MohdAltaaf/Keychains/BOM.csv

Part Name | Quantity | Unit Price | Total Price | Purchase Link
Seeed Studio XIAO ESP32C3 | 2 | 8.89$ | 17.78$ | https://techiesms.com/product/seeed-studio-xiao-esp32c3-the-smallest-esp32c3-development-board/
1.3 Inch I2C OLED 4-pin SH1106 | 2 | 3.89$ | 7.78$ | https://shop.controllerstech.com/products/1-3-inch-i2c-oled-display-module-4pin-white-sh1106
KP 481035 150mAh 3.7V LiPo Battery | 2 | 3.33$ | 6.66$ | https://zbotic.in/product/kp-original-481035-150mah-3-7vsingle-cell-rechargeable-lipo-battery/
Mini SPDT Slide Switch 3-pin | 2 | 0.22$ | 0.44$ | https://probots.co.in/mini-spdt-slide-switch-3-pin-pcb-mount.html
3D-printed enclosure (own STL) | 2 | 1.67$ | 3.34$
Delivery Charges and shipping (if applicable) |  |  | 10$
Grand Total |  |  | 46.00$
