MohdAltaaf/Keychains/3D Model/Full body.step

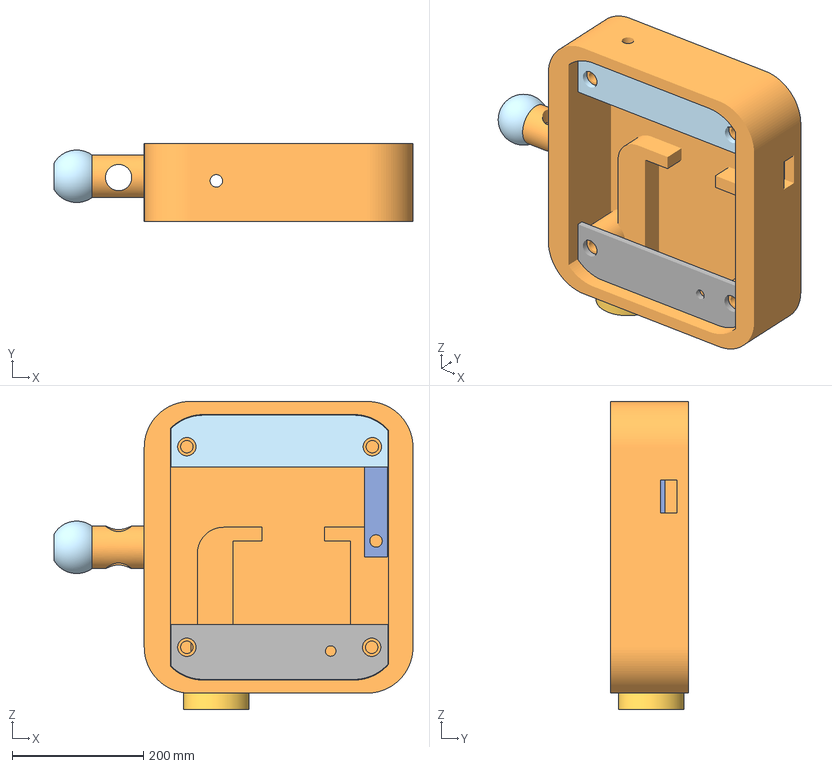
[picture p1: CAD file, 2026-10-27]
3D Model/Full body.step
547.7 x 119.0 x 470.0 mm
