MohdAltaaf/Keychains/3D Model/Switch_cover.stl

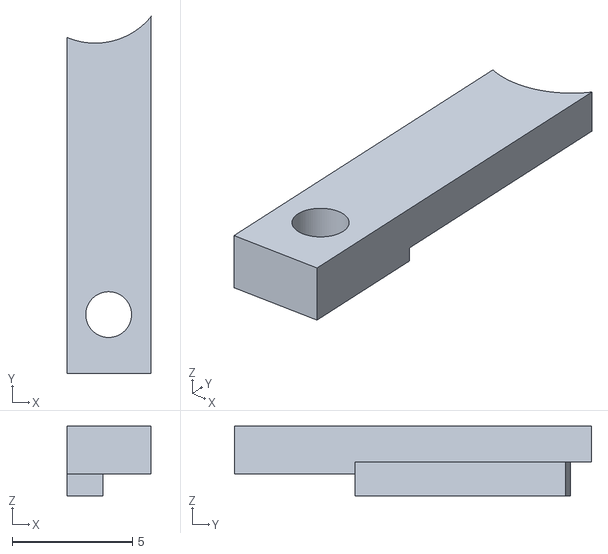
[picture p2: CAD file, 2026-10-27]
3D Model/Switch_cover.stl
3.50 x 14.8 x 2.90
