MohdAltaaf/Keychains/3D Model/Body.stl

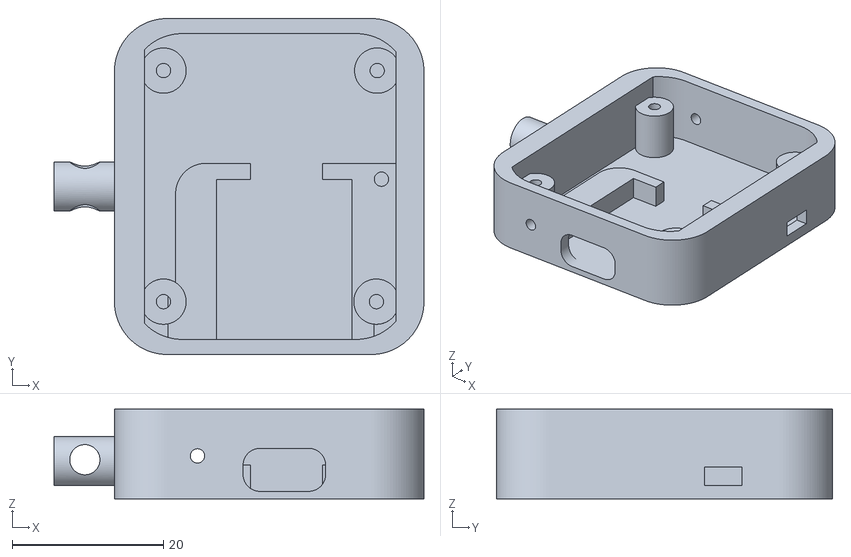
[picture p3: CAD file, 2026-10-27]
3D Model/Body.stl
49.0 x 44.5 x 11.9
