MohdAltaaf/Keychains/3D Model/CoverR.stl

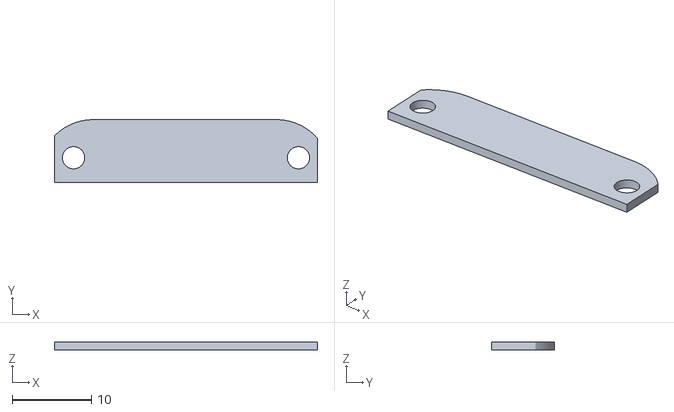
[picture p4: CAD file, 2026-10-27]
3D Model/CoverR.stl
33.1 x 7.90 x 1.00
