MohdAltaaf/Keychains/3D Model/Ear1.stl

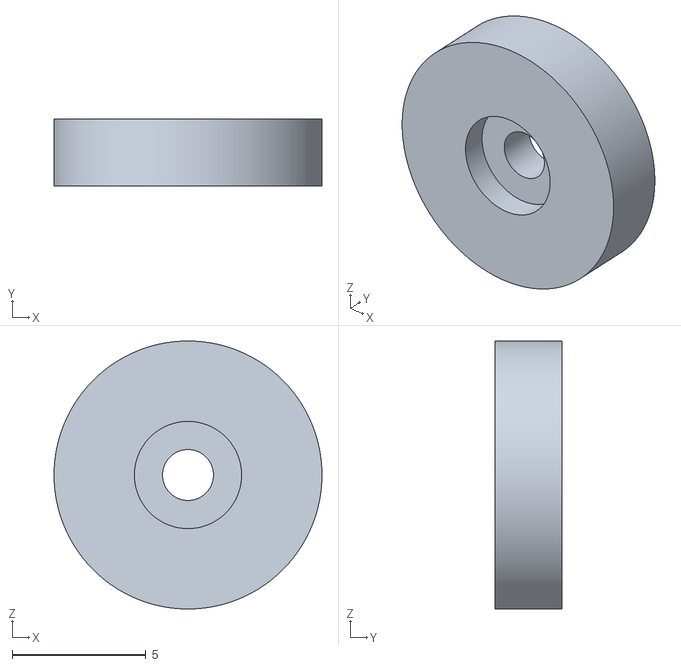
[picture p5: CAD file, 2026-10-27]
3D Model/Ear1.stl
10.0 x 2.50 x 10.00
