MohdAltaaf/Keychains/3D Model/CoverL.stl

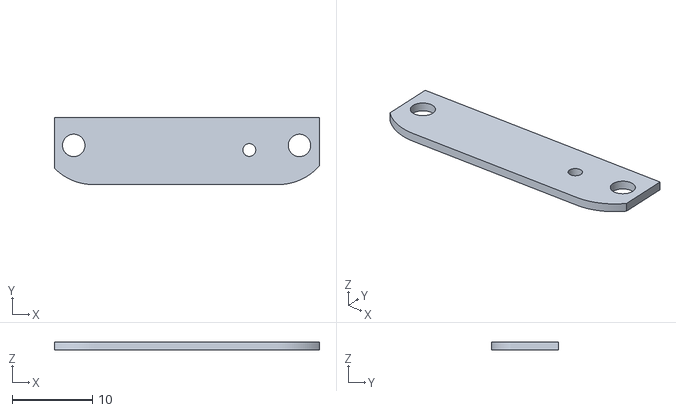
[picture p6: CAD file, 2026-10-27]
3D Model/CoverL.stl
33.1 x 8.40 x 1.00
