MohdAltaaf/Keychains/3D Model/Top.stl

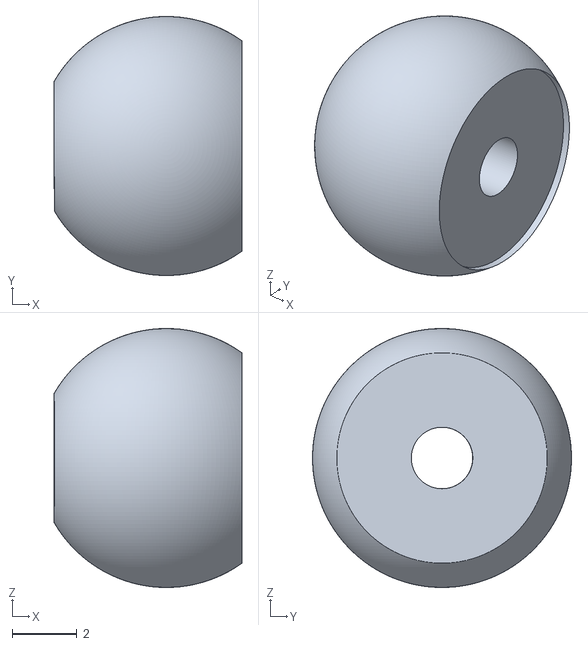
[picture p7: CAD file, 2026-10-27]
3D Model/Top.stl
5.80 x 8.00 x 8.00
