MohdAltaaf/Keychains/(commit log)

2026-10-27 Revise README for Pair Keychains project
    Expanded the README to provide detailed information about the Pair Keychains project, including functionality, setup instructions, wiring details, and known limitations.
2026-10-27 Add BOM.csv with component details and suppliers
    [BOM.csv]
2026-10-27 Revise BOM structure and add supplier links
    Updated BOM with new format and additional details.
    [BOM.csv]
2026-10-27 Revise BOM.csv to new format with pricing
    Updated BOM format and pricing details.
    [BOM.csv]
2026-10-27 added wiring diagram
2026-10-27 Update README with new image and battery info
    Added additional image and battery connection instructions.
2026-10-27 Add project journal entry for Pair Keychains
    Documented the development process for the Pair Keychains project, detailing the idea, parts, case modeling, wiring diagram, and coding efforts.
2026-10-27 Update JOURNAL.md with project details and images
    Added images and detailed sections for case modeling, wiring diagram, and code implementation.
2026-10-27 Organised better
    [Body.stl, CoverL.stl, CoverR.stl, Ear1.stl, Full body.step, Switch_cover.stl, Top.stl]
